crespum/ilumi/hardware/ilumi.kicad_pcb

## KiCad design hardware/ilumi.kicad_pcb (2017-06-07)

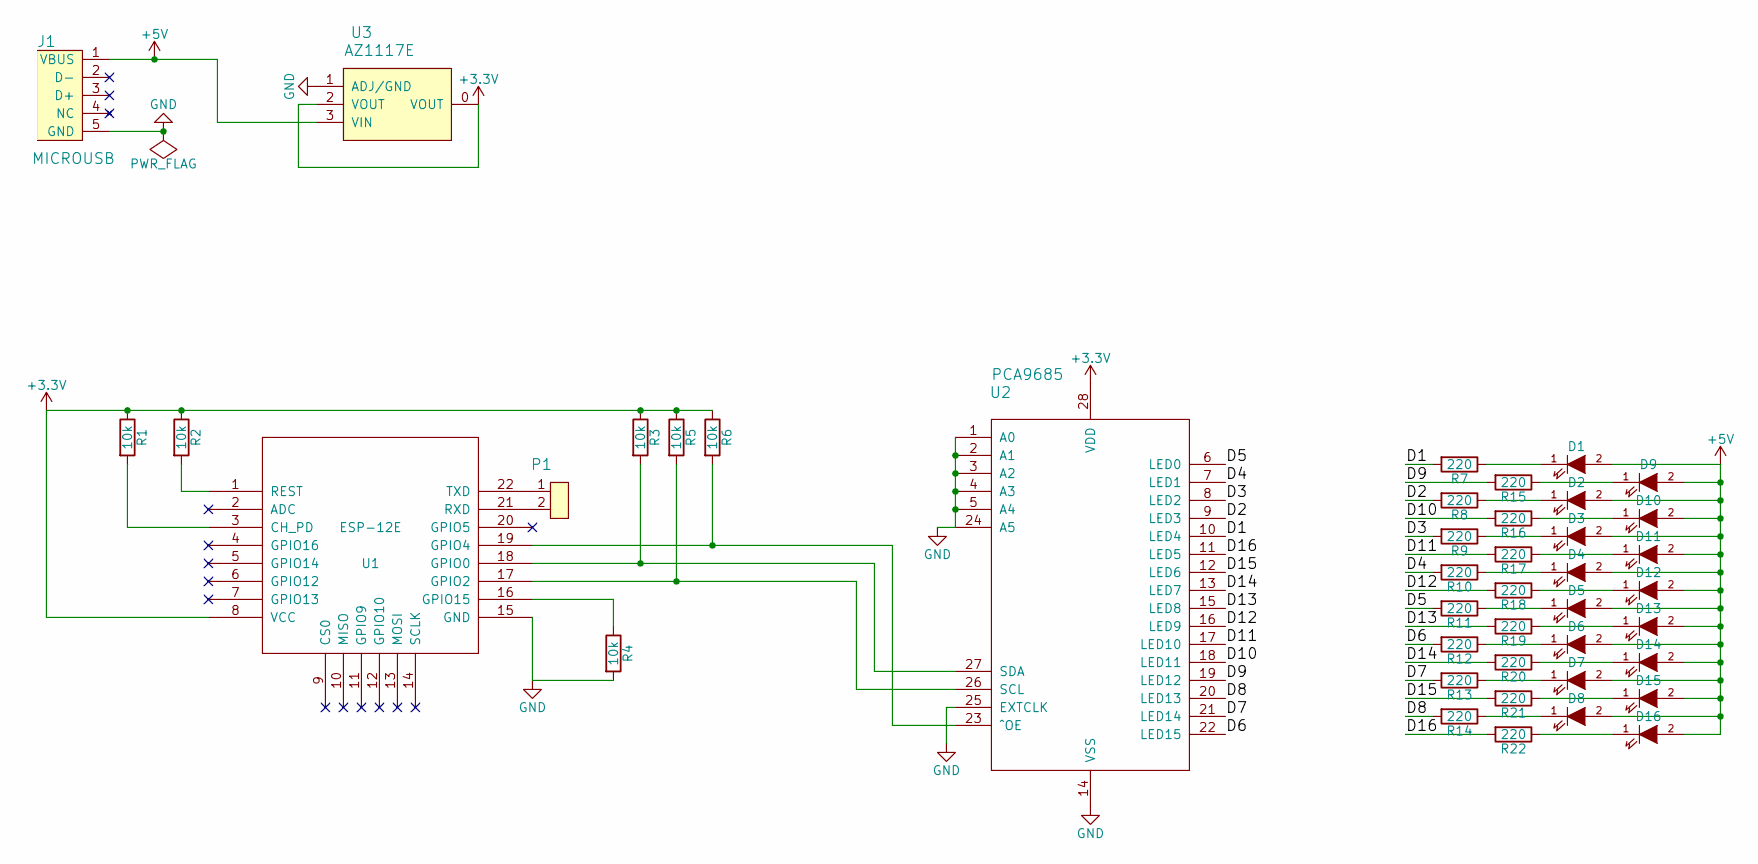
[picture p1: schematic ilumi.sch]

Parts:
D1, D2, D3, D4, D5, D6, D7, D8, D9, D10, D11, D12, D13, D14, D15, D16: LED; LED_ILUMI
J1: MICROUSB; MICROUSB_th
P1: 2PIN_MALE; SIP2
R1, R2, R3, R4, R5, R6: 10k; R_0603
R7, R8, R9, R10, R11, R12, R13, R14, R15, R16, R17, R18, R19, R20, R21, R22: 220; R_0603
U1: ESP-12E
U2: PCA9685; HTSSOP28
U3: AZ1117E; SOT223

Connections:
+3V3: R1.1, R2.1, R3.1, R5.1, R6.1, U1.8 (VCC), U2.28 (VDD), U3.0 (VOUT), U3.2 (VOUT)
+5V: D1.2 (A), D2.2 (A), D3.2 (A), D4.2 (A), D5.2 (A), D6.2 (A), D7.2 (A), D8.2 (A), D9.2 (A), D10.2 (A), D11.2 (A), D12.2 (A), D13.2 (A), D14.2 (A), D15.2 (A), D16.2 (A), J1.1 (VBUS), U3.3 (VIN)
/D1: R7.2, U2.10 (LED4)
/D2: R8.2, U2.9 (LED3)
/D3: R9.2, U2.8 (LED2)
/D4: R10.2, U2.7 (LED1)
/D5: R11.2, U2.6 (LED0)
/D6: R12.2, U2.22 (LED15)
/D7: R13.2, U2.21 (LED14)
/D8: R14.2, U2.20 (LED13)
/D9: R15.2, U2.19 (LED12)
/D10: R16.2, U2.18 (LED11)
/D11: R17.2, U2.17 (LED10)
/D12: R18.2, U2.16 (LED9)
/D13: R19.2, U2.15 (LED8)
/D14: R20.2, U2.13 (LED7)
/D15: R21.2, U2.12 (LED6)
/D16: R22.2, U2.11 (LED5)
GND: J1.5 (GND), R4.2, U1.15 (GND), U2.1 (A0), U2.2 (A1), U2.3 (A2), U2.4 (A3), U2.5 (A4), U2.14 (VSS), U2.24 (A5), U2.25 (EXTCLK), U3.1 (ADJ/GND)
unnamed: D1.1 (K), R7.1
unnamed: D2.1 (K), R8.1
unnamed: D3.1 (K), R9.1
unnamed: D4.1 (K), R10.1
unnamed: D5.1 (K), R11.1
unnamed: D6.1 (K), R12.1
unnamed: D7.1 (K), R13.1
unnamed: D8.1 (K), R14.1
unnamed: D9.1 (K), R15.1
unnamed: D10.1 (K), R16.1
unnamed: D11.1 (K), R17.1
unnamed: D12.1 (K), R18.1
unnamed: D13.1 (K), R19.1
unnamed: D14.1 (K), R20.1
unnamed: D15.1 (K), R21.1
unnamed: D16.1 (K), R22.1
unnamed: P1.1, U1.22 (TXD)
unnamed: P1.2, U1.21 (RXD)
unnamed: R1.2, U1.3 (CH_PD)
unnamed: R2.2, U1.1 (REST)
unnamed: R3.2, U1.18 (GPIO0), U2.27 (SDA)
unnamed: R4.1, U1.16 (GPIO15)
unnamed: R5.2, U1.17 (GPIO2), U2.26 (SCL)
unnamed: R6.2, U1.19 (GPIO4), U2.23 (^OE)

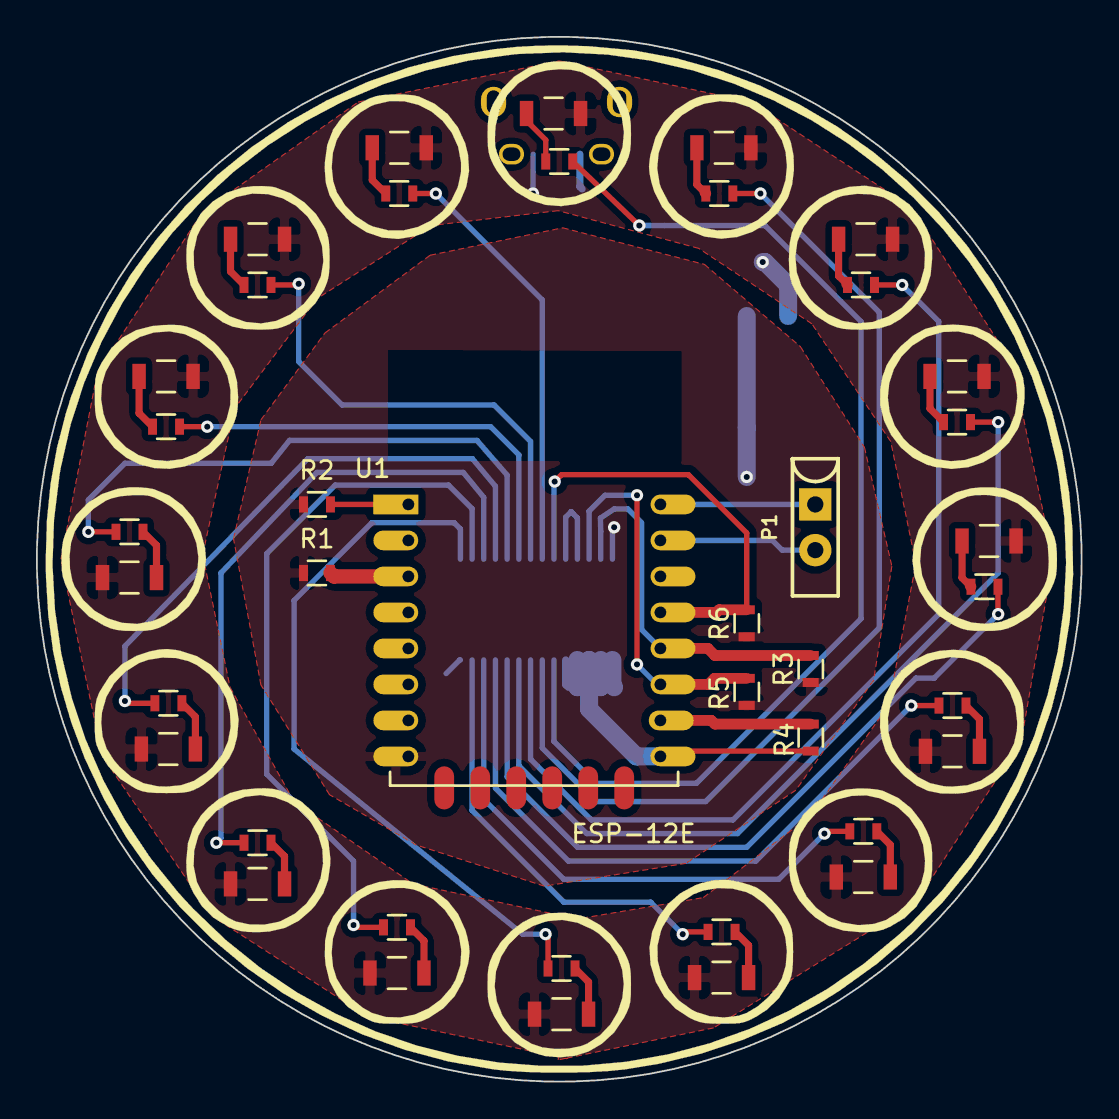
[picture p2: board ilumi.kicad_pcb from above]

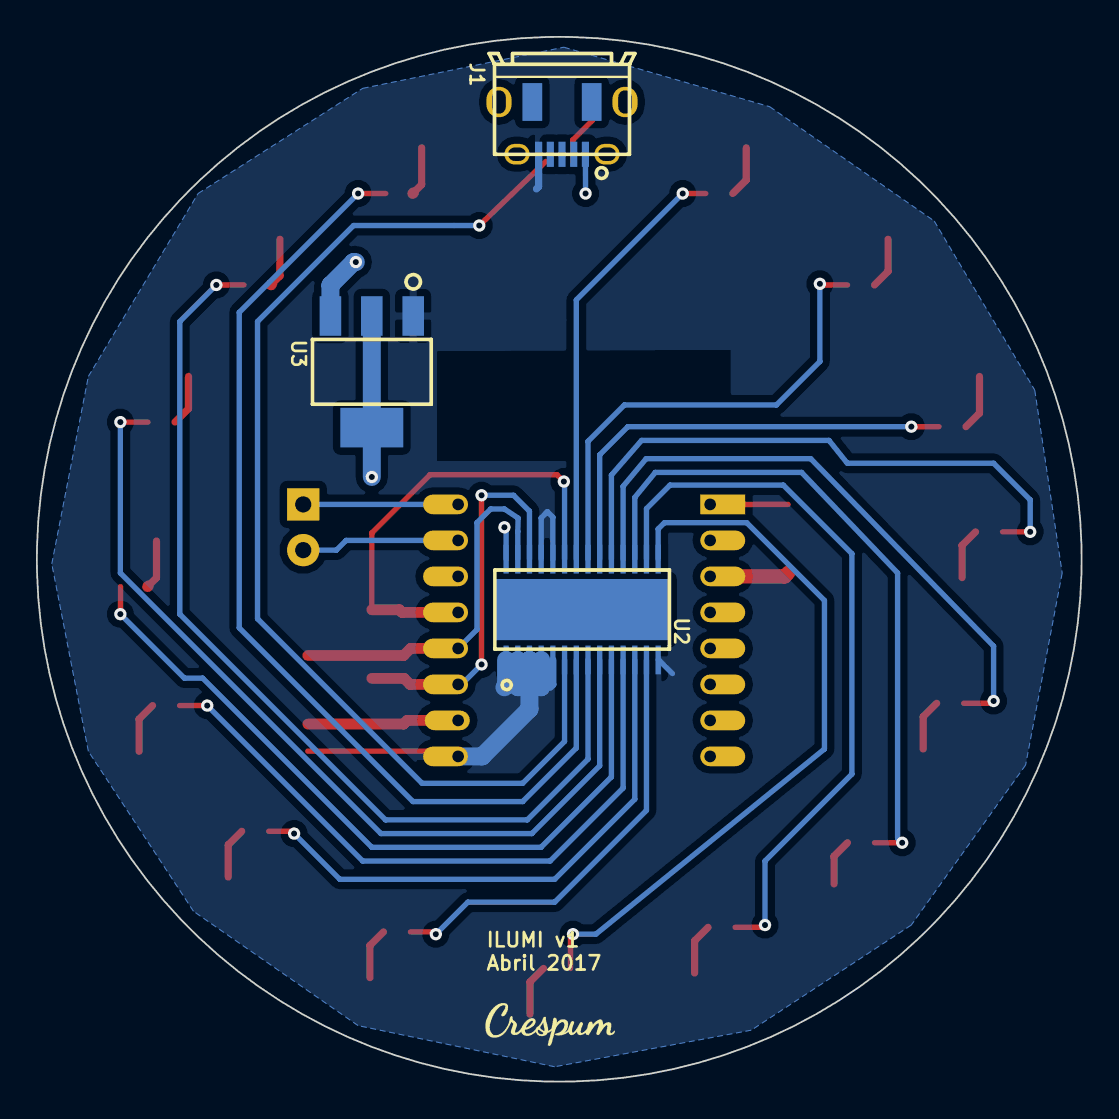
[picture p3: board ilumi.kicad_pcb from below]

Board: 2 copper layers, 58.0 x 58.0 mm, 43 parts (3 on the bottom side), 43 nets.
