crespum/ilumi/(commit log)

2017-06-07 [HW] PCB v1
    [ilumi.kicad_pcb, ilumi.sch]
2017-07-13 [PCB] Fix v1 issues - Add GND in UART header - Power LEDs driver with 5V
    [ilumi.sch]
2017-07-13 [PCA9685] Basic driver implementation
2018-02-13 fw: switch to Arduino-based firmware
2018-02-20 fw: switch PCA9685 library
2018-02-20 fw: correct LED on/off function call
    [main.ino]
